impexeris/DiY-Arduino-Geiger-Counter-SMD/Enclosure .files for 3D printing/anode adapter-SBM-20.stl

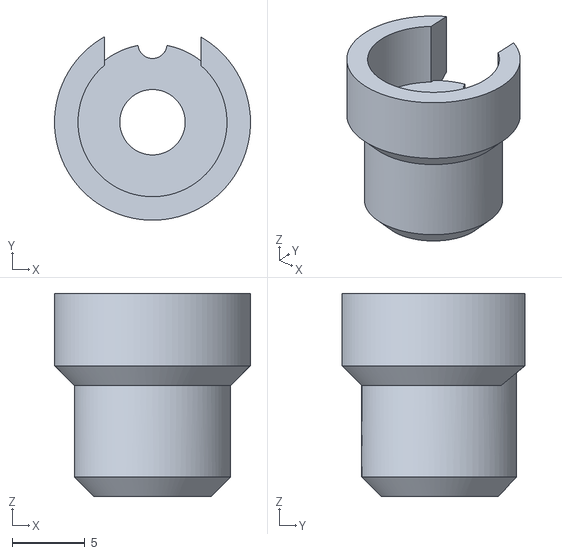
[picture p1: CAD file, 2021-09-28]
Enclosure .files for 3D printing/anode adapter-SBM-20.stl
13.5 x 12.6 x 14.0
