impexeris/DiY-Arduino-Geiger-Counter-SMD/Enclosure .files for 3D printing/sts6_body.stl

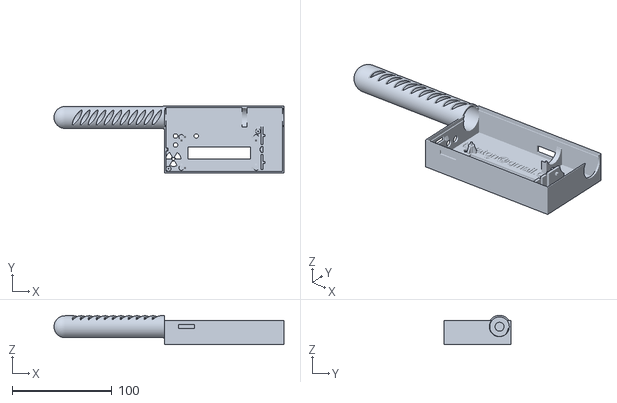
[picture p2: CAD file, 2020-12-28]
Enclosure .files for 3D printing/sts6_body.stl
230.8 x 67.0 x 29.4
