impexeris/DiY-Arduino-Geiger-Counter-SMD/Enclosure .files for 3D printing/sts6_cover.stl

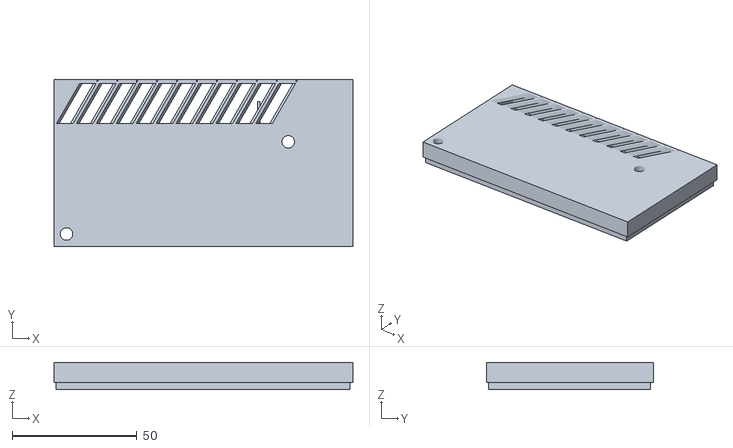
[picture p3: CAD file, 2020-12-28]
Enclosure .files for 3D printing/sts6_cover.stl
120.0 x 67.0 x 11.0
