impexeris/DiY-Arduino-Geiger-Counter-SMD/Enclosure .files for 3D printing/p5_bottom_for_sbt9_wbat_hole.stl

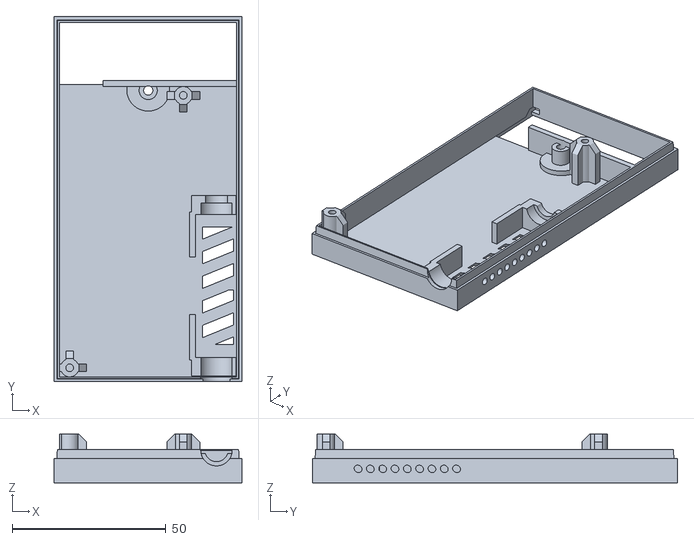
[picture p4: CAD file, 2020-04-20]
Enclosure .files for 3D printing/p5_bottom_for_sbt9_wbat_hole.stl
61.0 x 118.6 x 15.8
