impexeris/DiY-Arduino-Geiger-Counter-SMD/Enclosure .files for 3D printing/batterycompartmentcover.stl

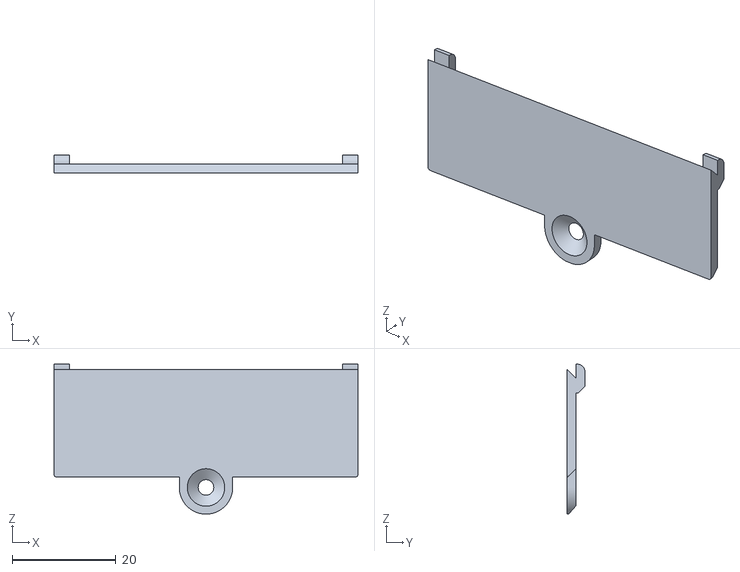
[picture p5: CAD file, 2017-10-04]
Enclosure .files for 3D printing/batterycompartmentcover.stl
58.6 x 3.45 x 28.9
