impexeris/DiY-Arduino-Geiger-Counter-SMD/Enclosure .files for 3D printing/P5_bottom_for_sbt11_with_accessible_battery_compartment.stl

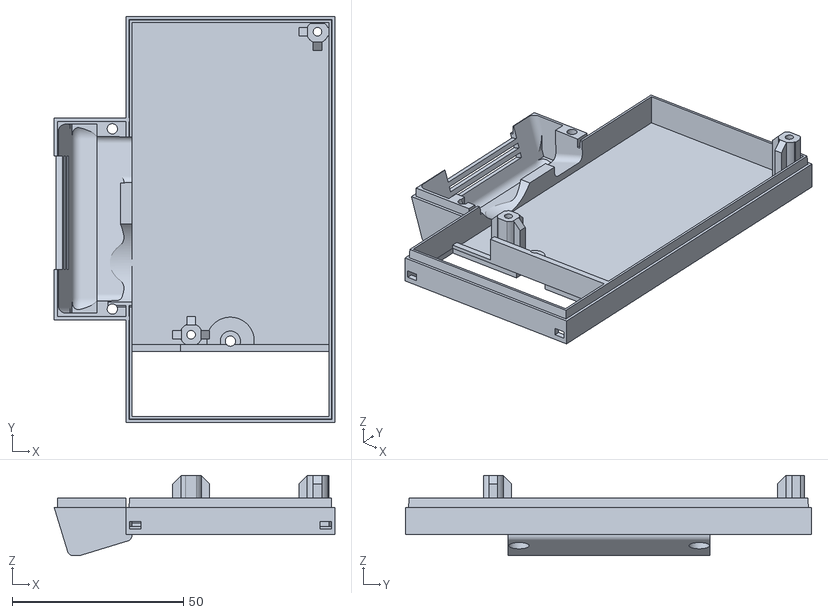
[picture p6: CAD file, 2017-10-01]
Enclosure .files for 3D printing/P5_bottom_for_sbt11_with_accessible_battery_compartment.stl
82.0 x 118.6 x 23.5
