impexeris/DiY-Arduino-Geiger-Counter-SMD/Enclosure .files for 3D printing/P5_bottom_for_sbt11.stl

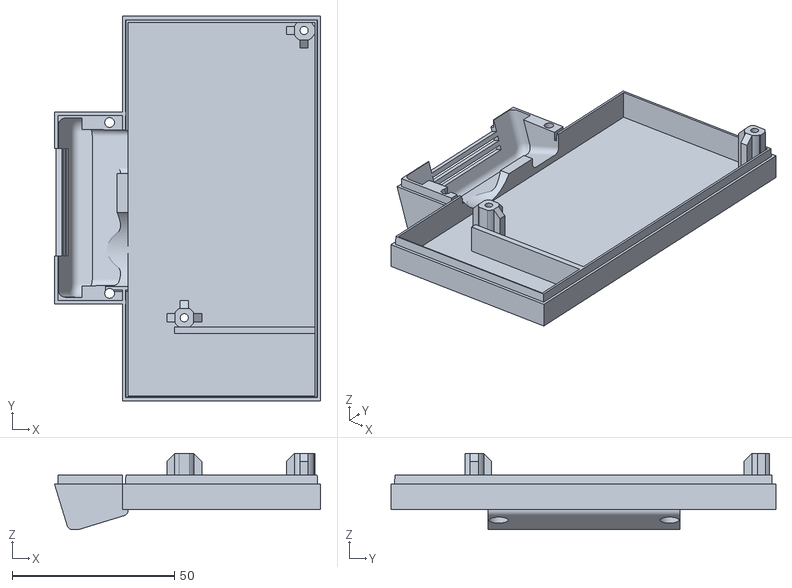
[picture p7: CAD file, 2017-09-21]
Enclosure .files for 3D printing/P5_bottom_for_sbt11.stl
82.0 x 118.6 x 23.5
