impexeris/DiY-Arduino-Geiger-Counter-SMD/Enclosure .files for 3D printing/P5_bottom_for_sbt9.stl

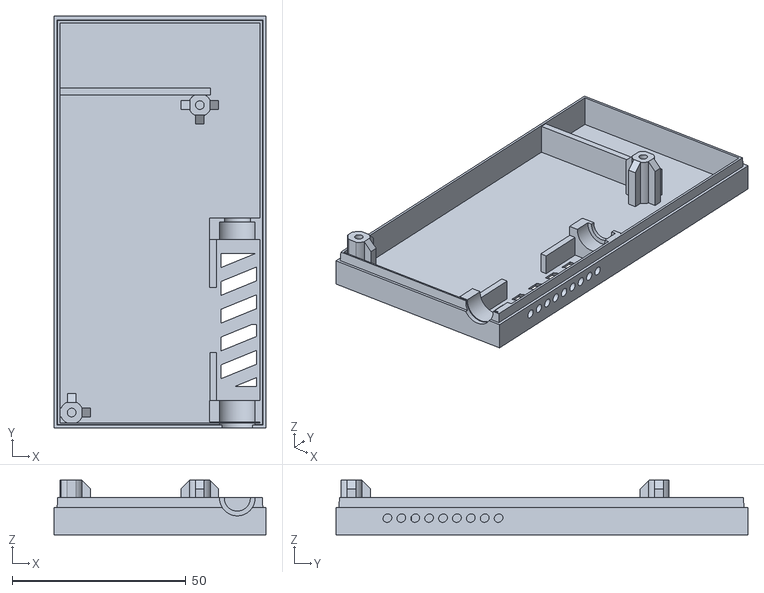
[picture p8: CAD file, 2017-08-27]
Enclosure .files for 3D printing/P5_bottom_for_sbt9.stl
61.0 x 118.6 x 15.8
