impexeris/DiY-Arduino-Geiger-Counter-SMD/Enclosure .files for 3D printing/Bottom-for-STS-5-geiger-tube.stl

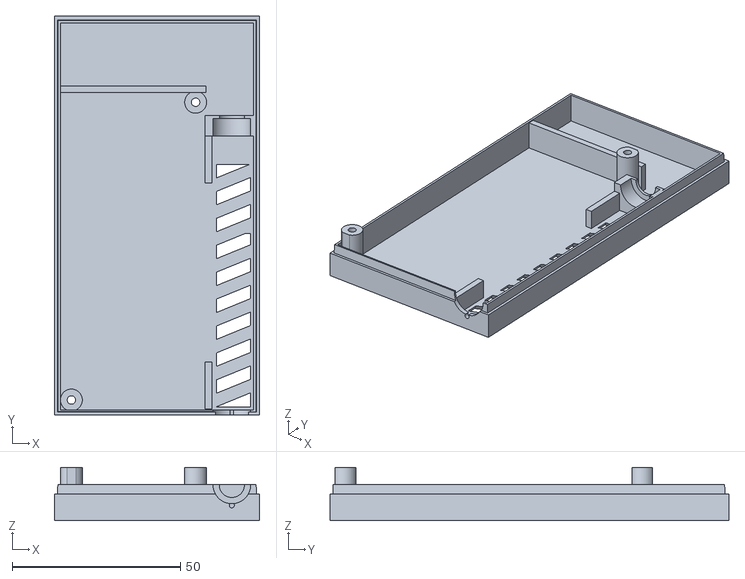
[picture p9: CAD file, 2017-08-27]
Enclosure .files for 3D printing/Bottom-for-STS-5-geiger-tube.stl
61.0 x 118.6 x 15.8
