impexeris/DiY-Arduino-Geiger-Counter-SMD/Enclosure .files for 3D printing/plug_for_serial.stl

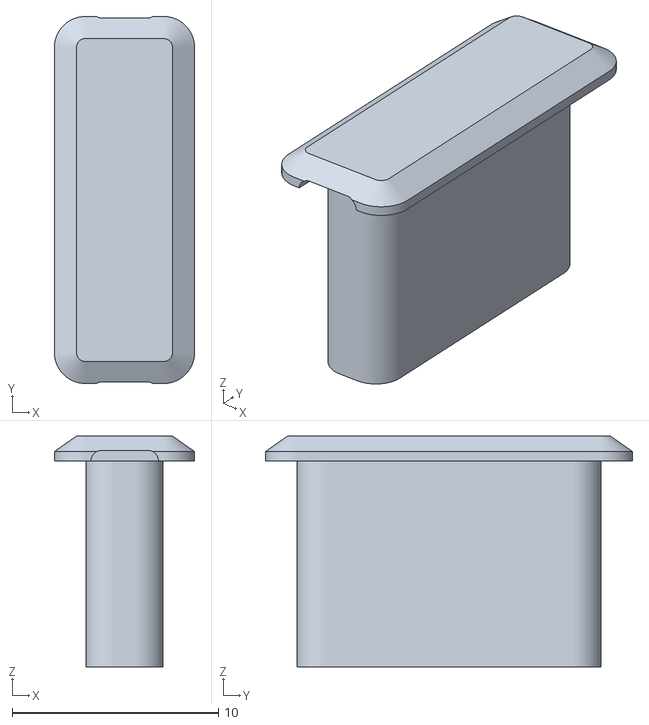
[picture p10: CAD file, 2017-08-27]
Enclosure .files for 3D printing/plug_for_serial.stl
6.80 x 17.8 x 11.2
