impexeris/DiY-Arduino-Geiger-Counter-SMD/(list of files, cad)

Other CAD files:
Enclosure .files for 3D printing/P5bottom-si29bg_with_accessible_battery_compartment.stl
Enclosure .files for 3D printing/P5_bottom_for_STS-5_with_accessible_battery_compartment.stl
Enclosure .files for 3D printing/P5_bottom_for_SBM20_with_accessible_battery_compartment.stl
Enclosure .files for 3D printing/P5bottom-si29bg.stl
Enclosure .files for 3D printing/Enclosure5bottom.stl
