impexeris/DiY-Arduino-Geiger-Counter-SMD/Circuit Schematics/Detector.pdf

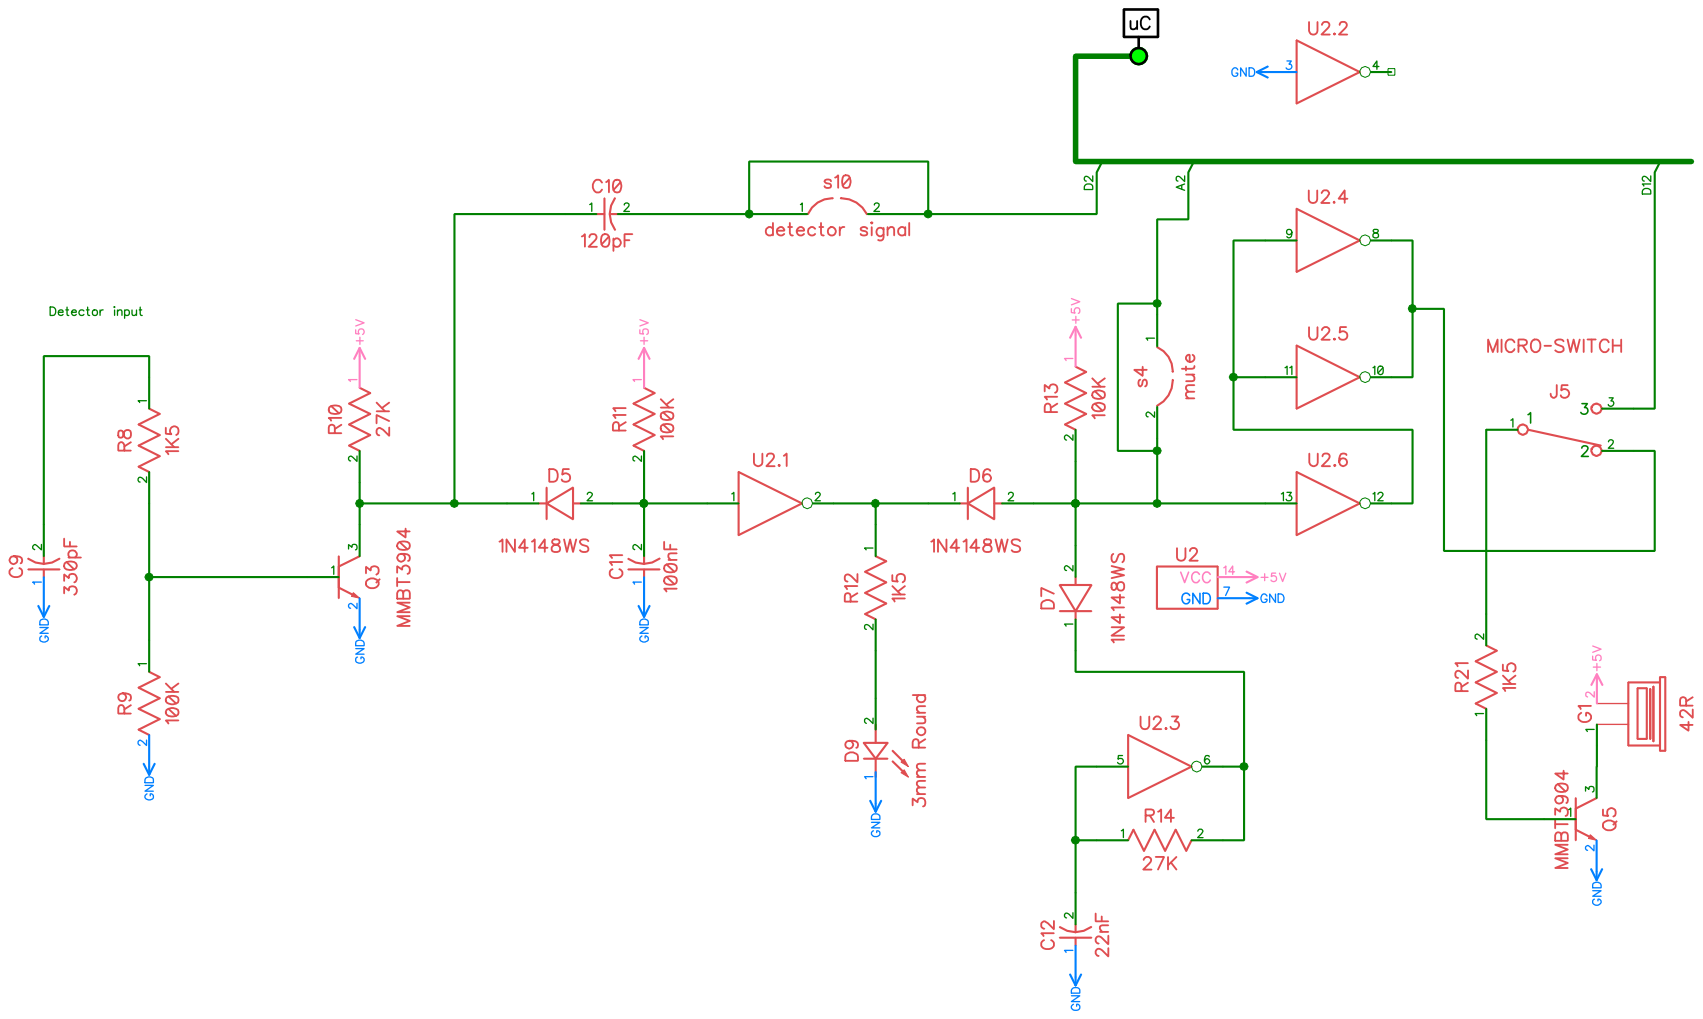
[picture p11: page 1]
