impexeris/DiY-Arduino-Geiger-Counter-SMD/Circuit Schematics/High Votage Generator.pdf

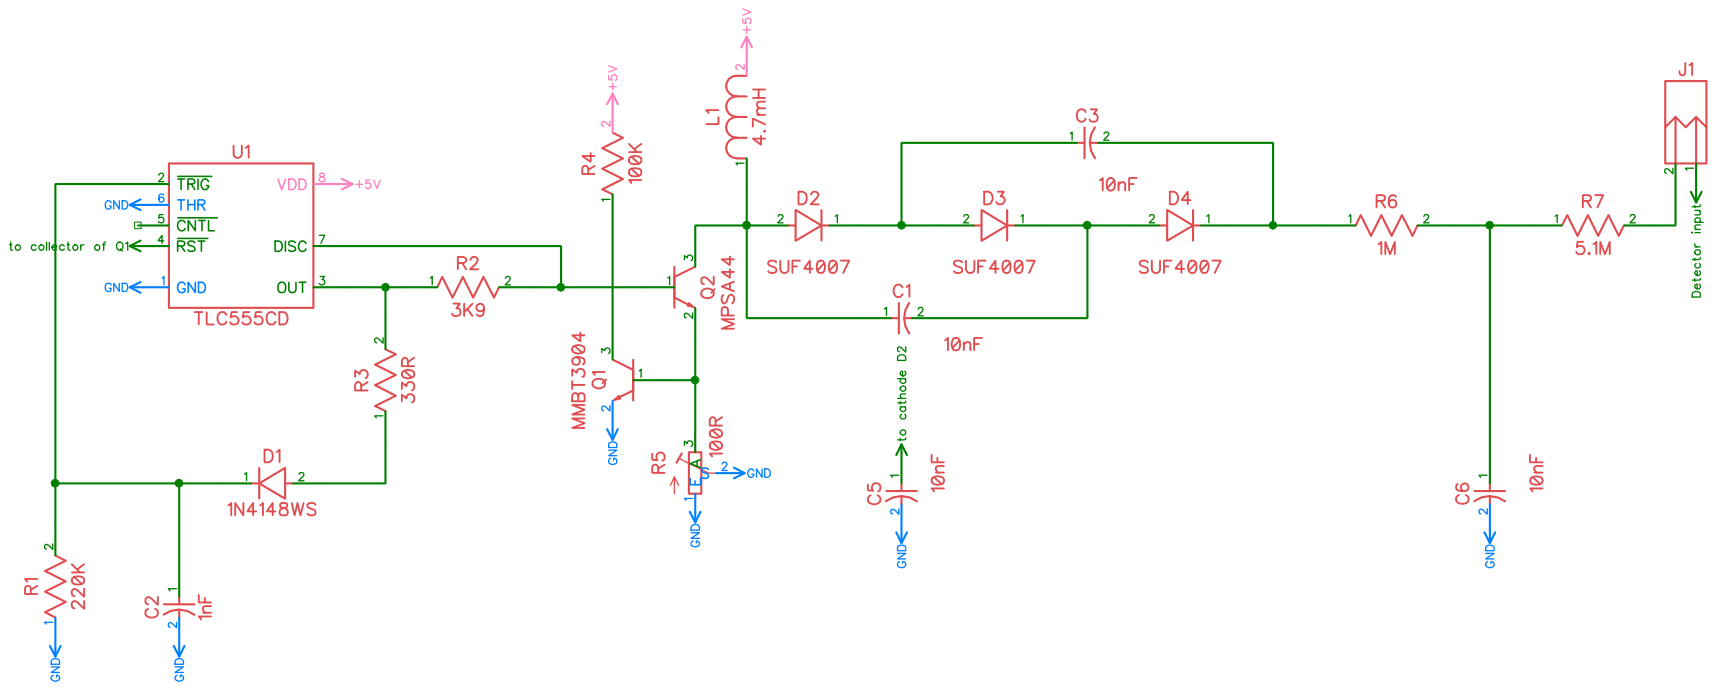
[picture p12: page 1]
