impexeris/DiY-Arduino-Geiger-Counter-SMD/Circuit Schematics/LCD contrast and brightness controls.pdf

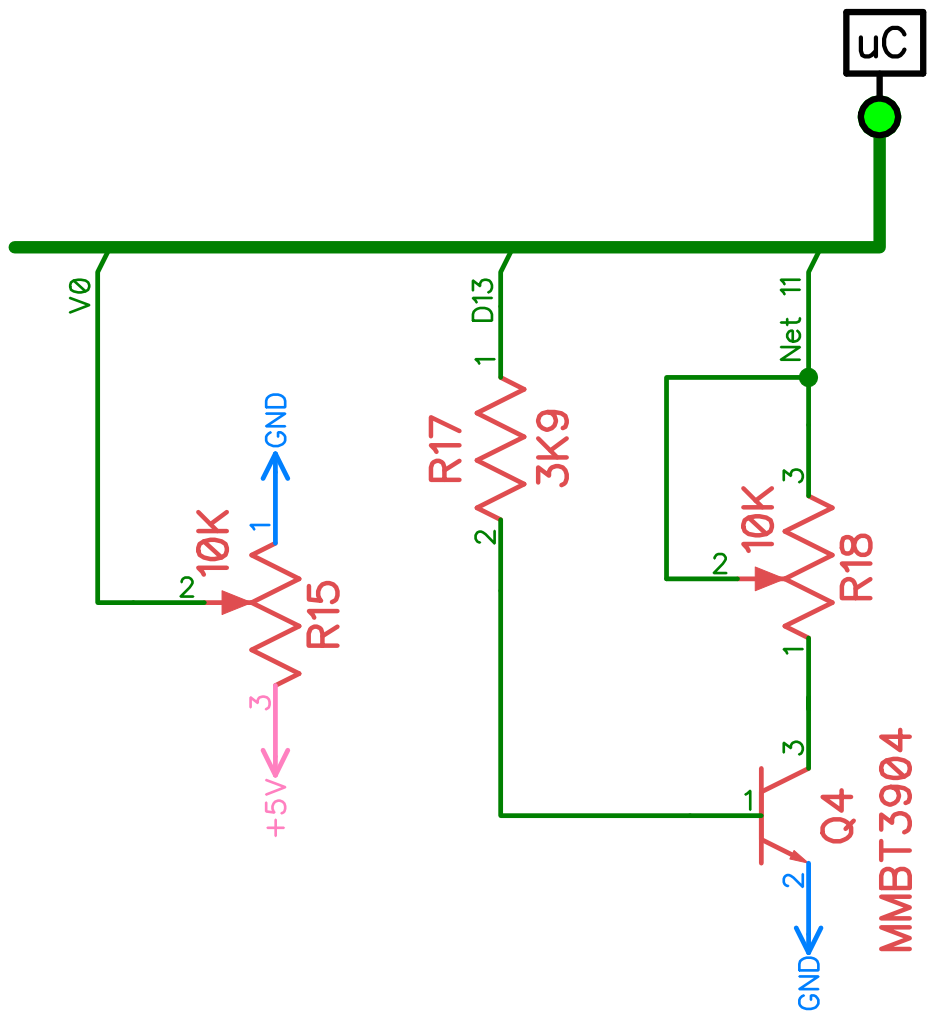
[picture p13: page 1]
