impexeris/DiY-Arduino-Geiger-Counter-SMD/Circuit Schematics/Microcontroller and LCD.pdf

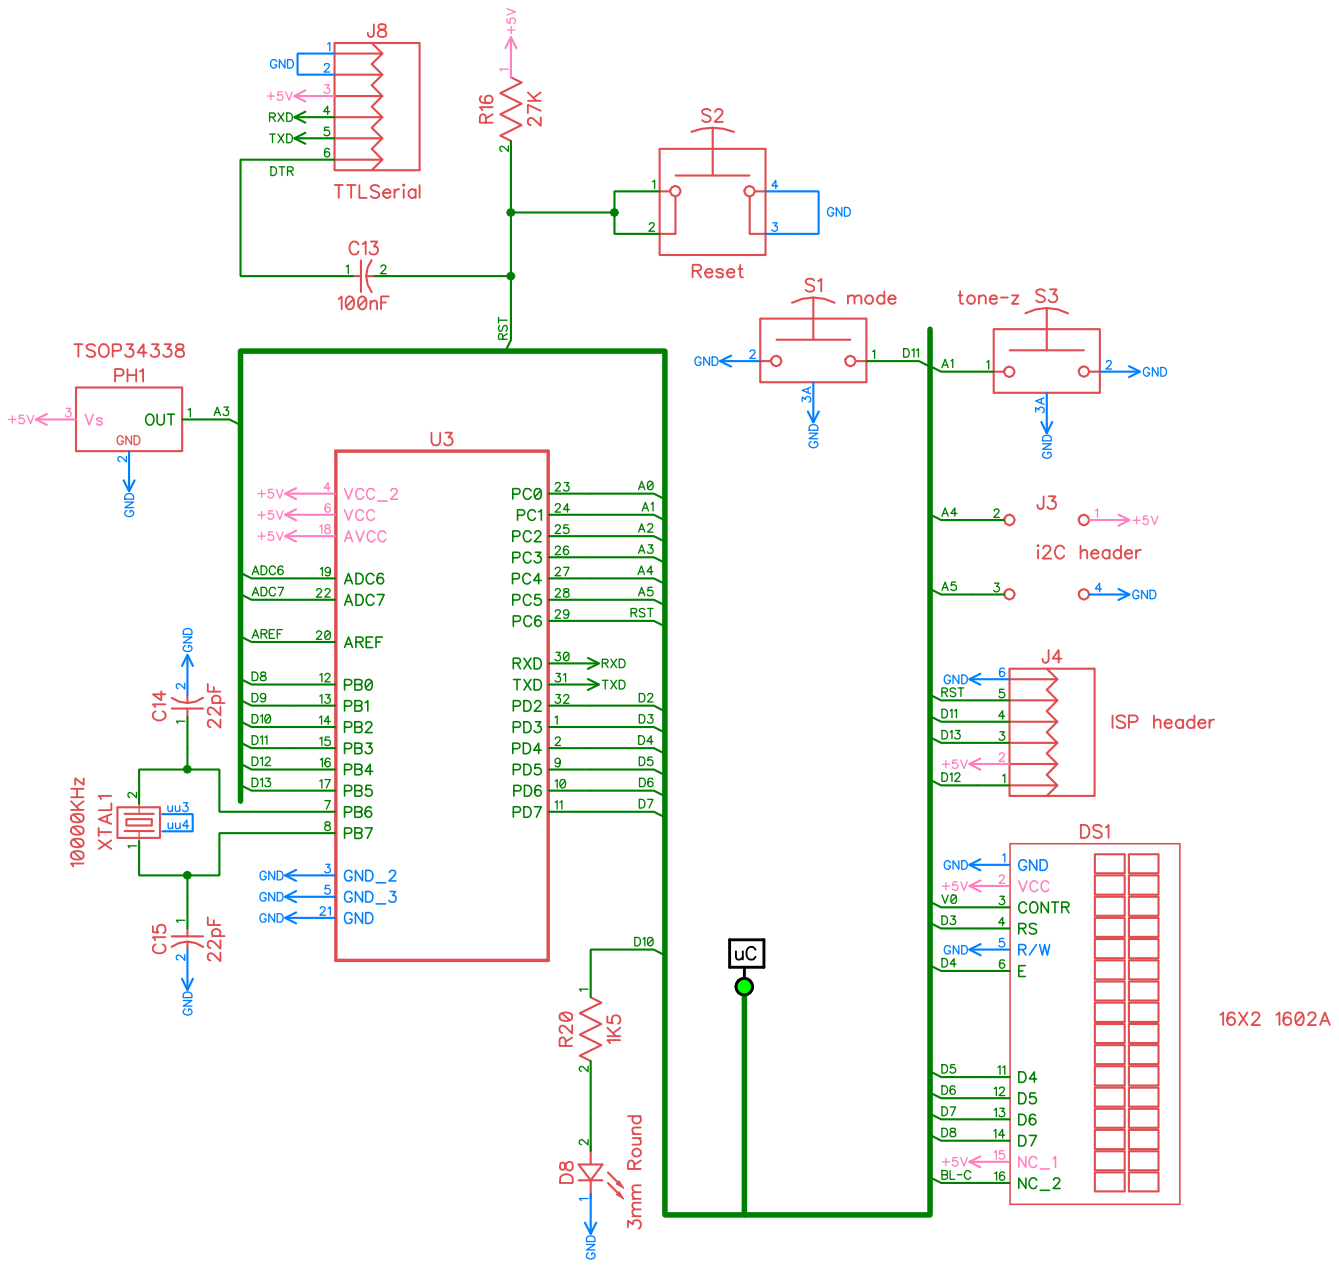
[picture p14: page 1]
