impexeris/DiY-Arduino-Geiger-Counter-SMD/(threads)

Thread 1 (2019-09-24):

net11

imre84, 2019-09-24:
Hi,

I can't see where this "net11" connects to:

https://github.com/impexeris/DiY-Arduino-Geiger-Counter-SMD/blob/master/Circuit%20Schematics/LCD%20contrast%20and%20brightness%20controls.pdf

thanks for the fix/clarification in advance.

Imre

impexeris, 2019-10-09:
it connects to the pin 16 of the display DS1
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

Closed 2019-10-09.
