impexeris/DiY-Arduino-Geiger-Counter-SMD/(commit log)

2016-11-29 Initial upload or schematics files
2016-11-30 PCB layout added
    PCB layout folder created
    PCB layout files uploaded
    README file uploaded
2016-11-30 Reduced the size of the PCB layout file
2016-11-30 Removed the PCB layout folder
2016-12-02 add STL files for a 3D printed enclosure
    [Enclosure5bottom.stl]
2017-09-18 Added .stl files of the enclosure for SBT-11
    Added .stl files of the enclosure for SBT-11 / SBT-11A Geiger Müller tubes
    [P5_bottom_for_sbt11.stl]
2017-09-18 Added reference to files for SBT-11 tubes
    Added reference to .stl files for SBT-11 / SBT-11A tubes
2017-09-20 Add files via upload
    Added Cover for SBT-11 mica window - one closed and two with place for inserts (for example paper insert to stop alpha but let through beta)
2017-09-20 re-uploaded
    Changed file "Cover with wider filter insert for SBT11 window"
2017-09-21 reuploaded the file
    with a cosmetic correction
    [P5_bottom_for_sbt11.stl]
2017-09-21 made changes to re-uploaded files
    thicker protective grill
    thicker holding surface for screw heads
    [P5_bottom_for_sbt11.stl]
2017-10-01 added updated files of the bottom for SBT-11
    Added two files (P5_bottom_for_sbt11_with_accessible_battery_compartment.stl and batterycompartmentcover.stl)
    the first one has the following adjustments:
    Adjusted the SBT-11 holder so the whole bottom snaps on easily.
    Introduced the battery compartment opening.
    The other file is the cover for the battery compartment opening.
    [P5_bottom_for_sbt11_with_accessible_battery_compartment.stl, batterycompartmentcover.stl]
2017-10-04 Adjusted the batterycompartmentcover.stl
    better fit
    [batterycompartmentcoverlonger.stl]
2017-10-04 bottom with battery compartment opening for
    SBM20 and STS5 tubes
    [P5_bottom_for_SBM20_with_accessible_battery_compartment.stl, P5_bottom_for_STS-5_with_accessible_battery_compartment.stl]
2018-01-23 uploading updated top for SBM-20 tube
    this is an updated top for SBM-20 tube
    small corrections and changes
2018-06-18 si-29bg enclosure bottom part modification
    si-29bg enclosure bottom part modification to include opening for battery compartment.
    [P5bottom-si29bg_with_accessible_battery_compartment.stl]
2020-04-20 uploaded bottom stl for box for SBT9 with bat hole
    [p5_bottom_for_sbt9_wbat_hole.stl]
2020-12-28 box for STS6 tube (CTC-6) (#2)
    [sts6.scad, sts6_body.stl, sts6_cover.stl]
2021-09-28 adapter added for SBM-20 tubes with pin-anode
    anode end adapter for SBM-20 tubes with pin-anode to fit in the enclosure as an older SBM-20
    [anode adapter-SBM-20.stl]
